Olariu-Al/pyrojack-animatronic/cat_eye_pumpkin_STL_v2C/parts_overview.png

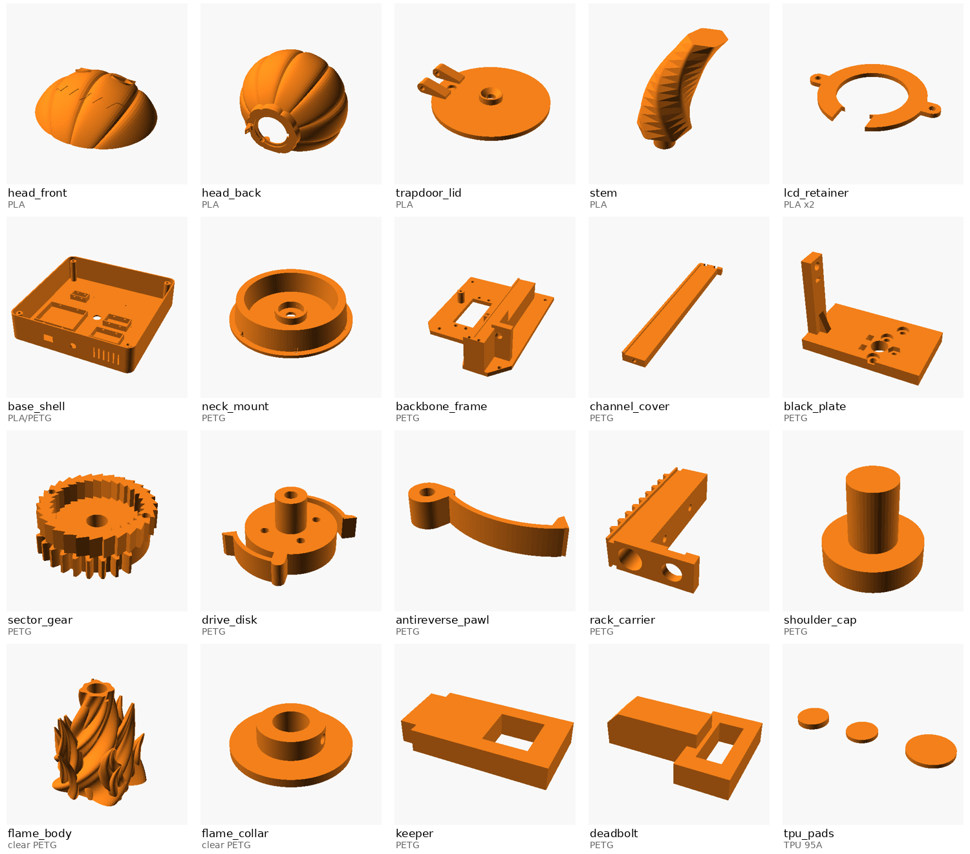
cat_eye_pumpkin_STL_v2C/parts_overview.png
