Olariu-Al/pyrojack-animatronic/cat_eye_pumpkin_STL_v2C/stl/tpu_pad_editat.STL

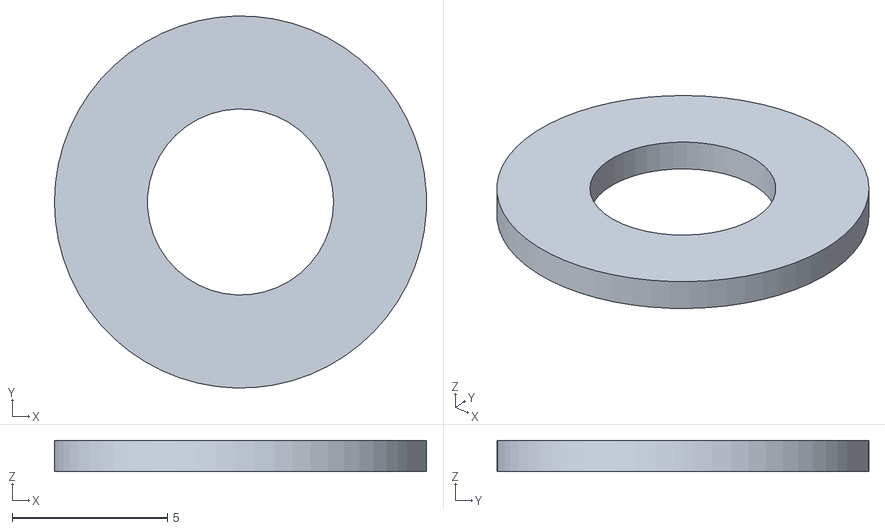
[picture p2: CAD file, 2026-10-29]
cat_eye_pumpkin_STL_v2C/stl/tpu_pad_editat.STL
12.0 x 12.0 x 1.00
