Olariu-Al/pyrojack-animatronic/pumpkin_v1C/stl/backbone_frame.3mf

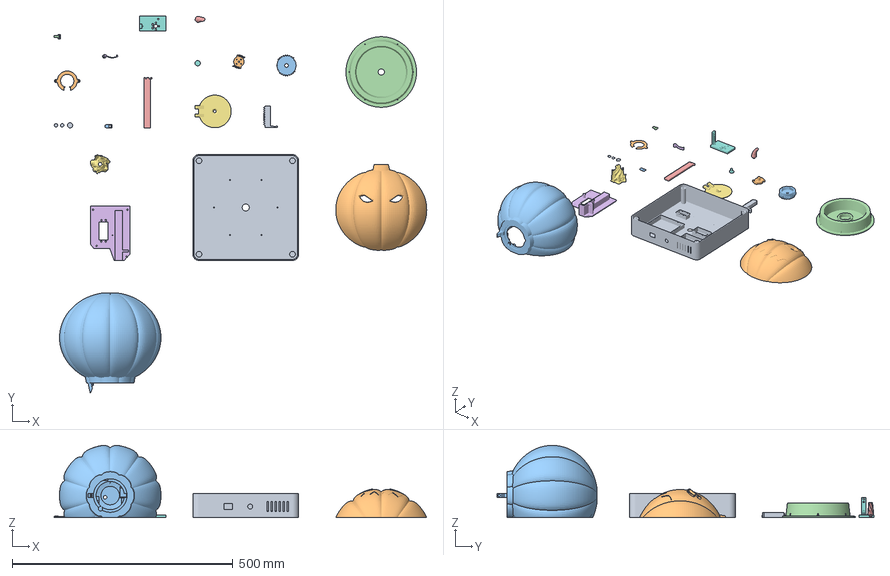
[picture p3: CAD file, 2026-10-23]
pumpkin_v1C/stl/backbone_frame.3mf
844.5 x 854.6 x 163.7 mm
tpu_pads.stl
lcd_retainer.stl
keeper.stl
deadbolt.stl
channel_cover.stl
antireverse_pawl.stl
trapdoor_lid.stl
shoulder_cap.stl
rack_carrier.stl
drive_disk.stl
sector_gear.stl
neck_mount.stl
stem.stl
backbone_frame.stl
flame_body.stl
black_plate.stl
base_shell.stl
head_front.stl
head_back.stl
