Olariu-Al/pyrojack-animatronic/cat_eye_pumpkin_STL_v2C/stl/everything.3mf

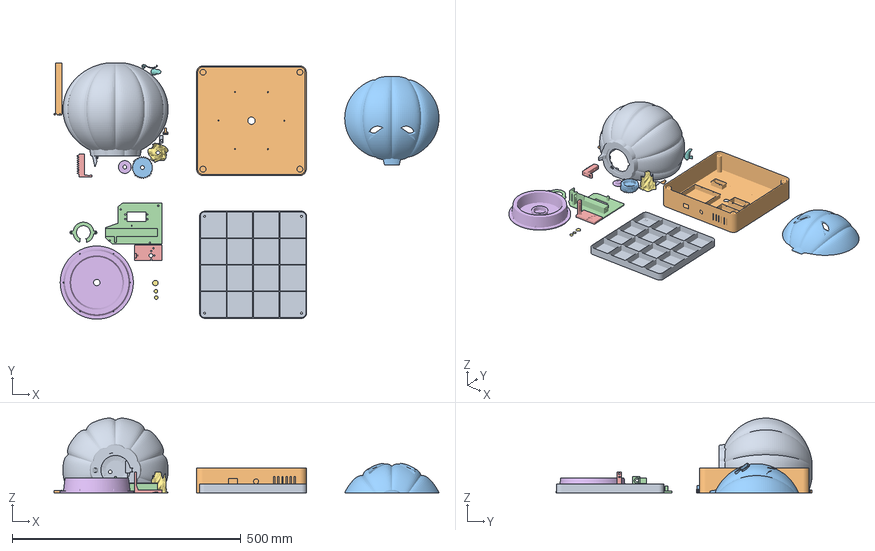
[picture p4: CAD file, 2026-10-25]
cat_eye_pumpkin_STL_v2C/stl/everything.3mf
842.3 x 560.8 x 163.7 mm
head_back.stl
base_shell.stl
head_front.stl
backbone_frame.stl
black_plate.stl
neck_mount.stl
flame_body.stl
stem.stl
base_lid.stl
channel_cover.stl
sector_gear.stl
lcd_retainer.stl
rack_carrier.stl
flame_collar.stl
tpu_pads.stl
antireverse_pawl.stl
keeper.stl
deadbolt.stl
