Olariu-Al/pyrojack-animatronic/cat_eye_pumpkin_STL_v2C/stl/base_lid.stl

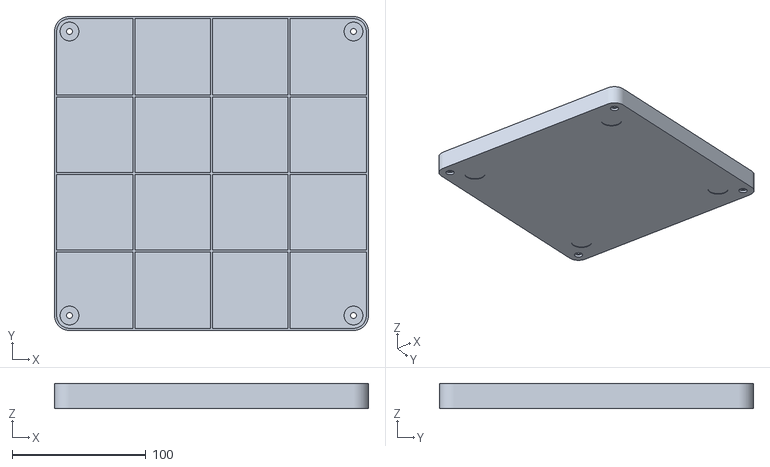
[picture p5: CAD file, 2026-10-25]
cat_eye_pumpkin_STL_v2C/stl/base_lid.stl
234.4 x 234.4 x 19.0
