Olariu-Al/pyrojack-animatronic/pumpkin_v1C/stl/flame_collar.stl

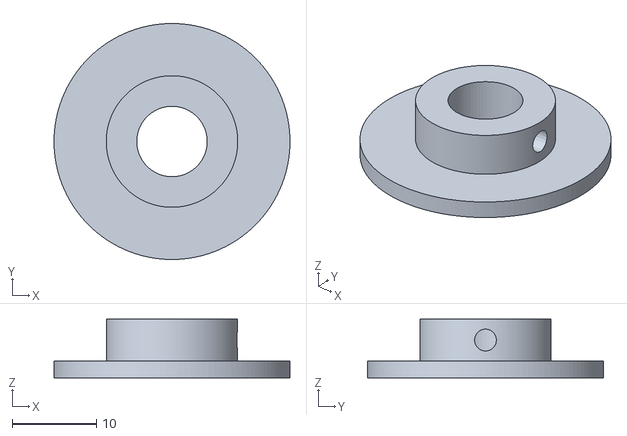
[picture p6: CAD file, 2026-10-23]
pumpkin_v1C/stl/flame_collar.stl
28.0 x 28.0 x 7.00
