Olariu-Al/pyrojack-animatronic/cat_eye_pumpkin_STL_v2C/stl/black_plate.stl

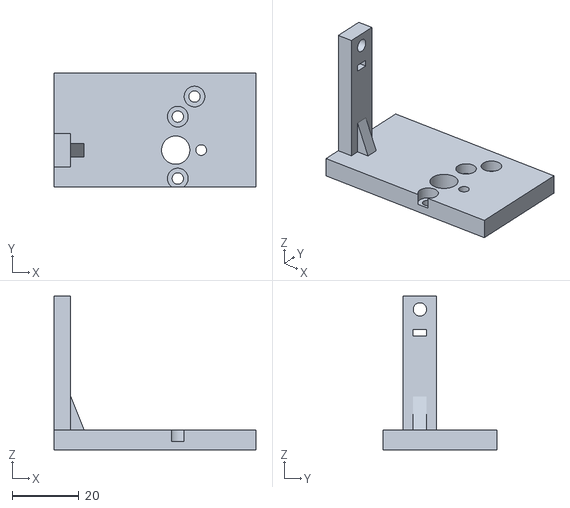
[picture p7: CAD file, 2026-10-23]
cat_eye_pumpkin_STL_v2C/stl/black_plate.stl
60.4 x 34.0 x 46.0
