Olariu-Al/pyrojack-animatronic/pumpkin_v1C/stl/tpu_pads.stl

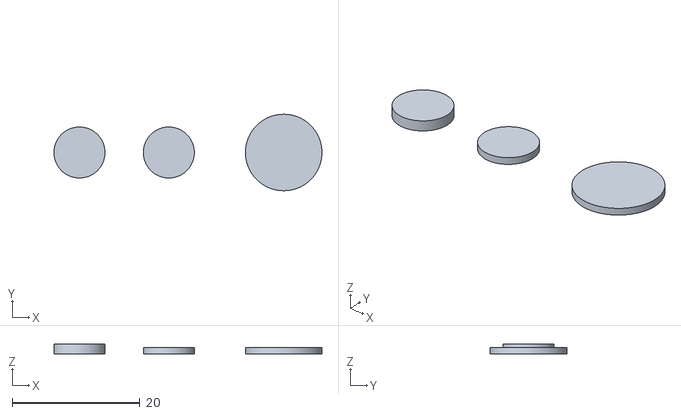
[picture p8: CAD file, 2026-10-23]
pumpkin_v1C/stl/tpu_pads.stl
42.0 x 12.0 x 1.50
