Olariu-Al/pyrojack-animatronic/cat_eye_pumpkin_STL_v2C/stl/head_back.stl

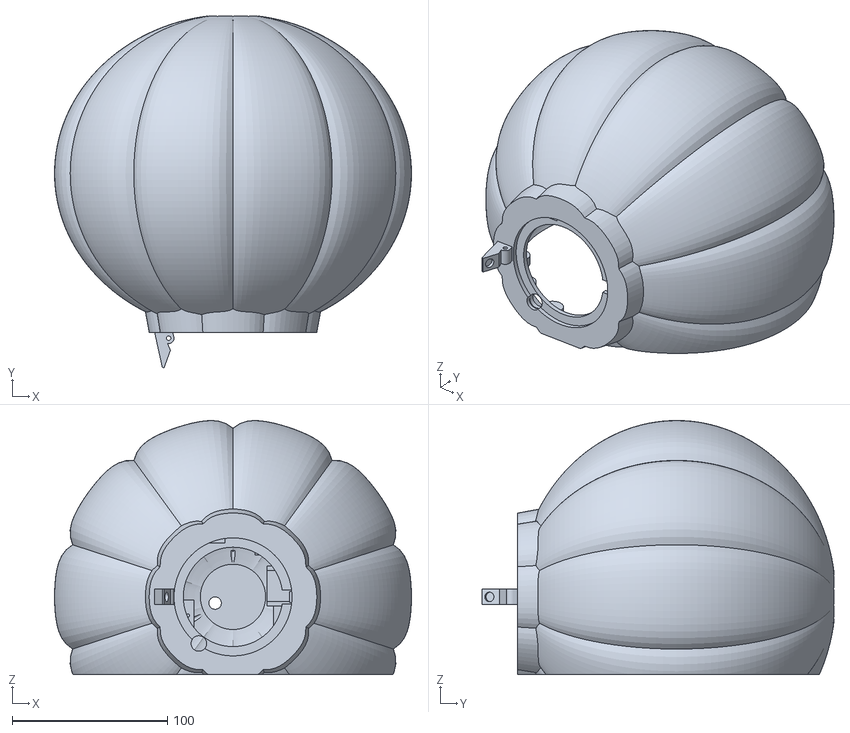
[picture p9: CAD file, 2026-10-23]
cat_eye_pumpkin_STL_v2C/stl/head_back.stl
230.0 x 226.6 x 163.7
