Olariu-Al/pyrojack-animatronic/pumpkin_v1C/stl/rack_carrier.stl

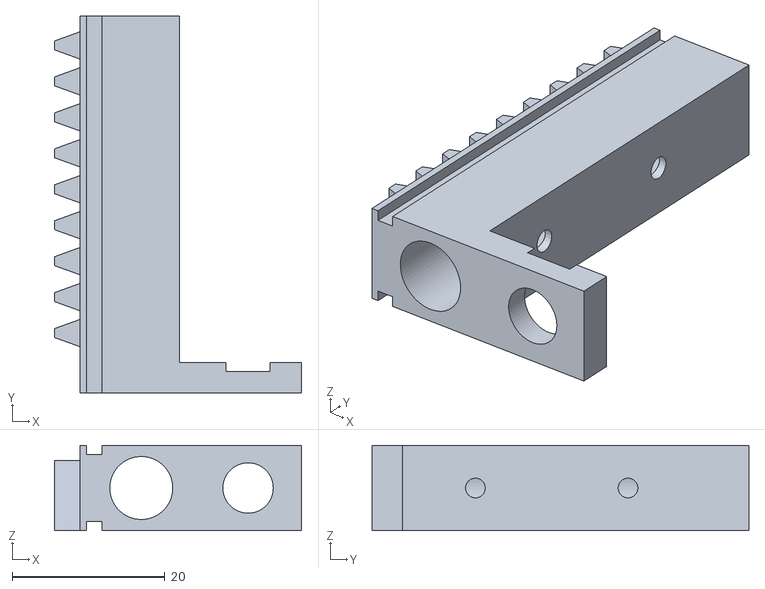
[picture p10: CAD file, 2026-10-23]
pumpkin_v1C/stl/rack_carrier.stl
32.4 x 49.4 x 11.2
