Olariu-Al/pyrojack-animatronic/cat_eye_pumpkin_STL_v2C/stl/backbone_frame.stl

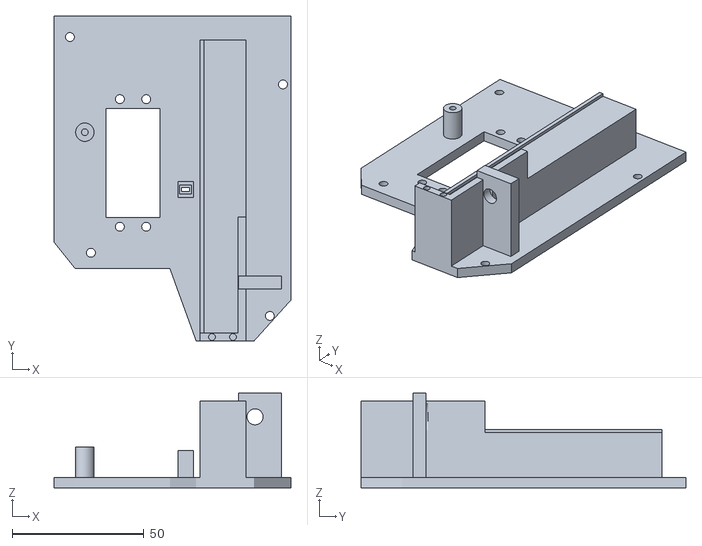
[picture p11: CAD file, 2026-10-23]
cat_eye_pumpkin_STL_v2C/stl/backbone_frame.stl
90.0 x 123.5 x 36.0
