Olariu-Al/pyrojack-animatronic/pumpkin_v1C/stl/channel_cover.stl

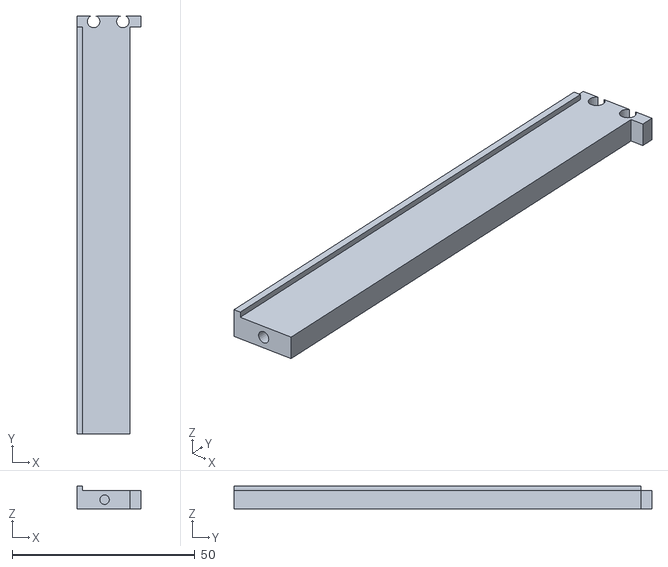
[picture p12: CAD file, 2026-10-23]
pumpkin_v1C/stl/channel_cover.stl
17.6 x 114.3 x 6.20
