Olariu-Al/pyrojack-animatronic/cat_eye_pumpkin_STL_v2C/stl/shoulder_cap.stl

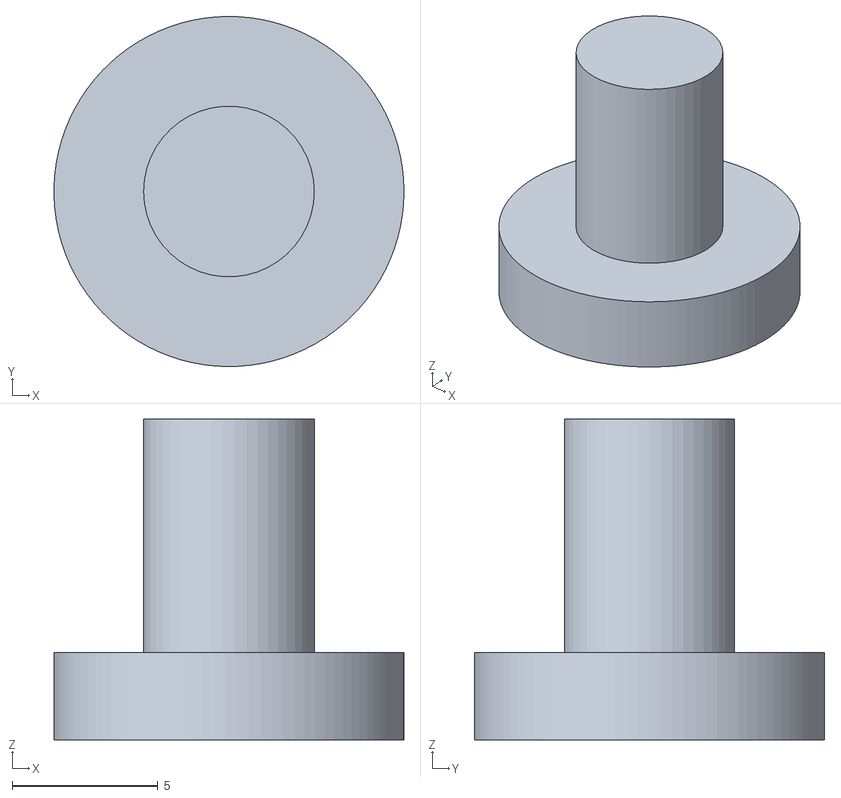
[picture p13: CAD file, 2026-10-23]
cat_eye_pumpkin_STL_v2C/stl/shoulder_cap.stl
12.0 x 12.0 x 11.0
