Olariu-Al/pyrojack-animatronic/pumpkin_v1C/stl/drive_disk.stl

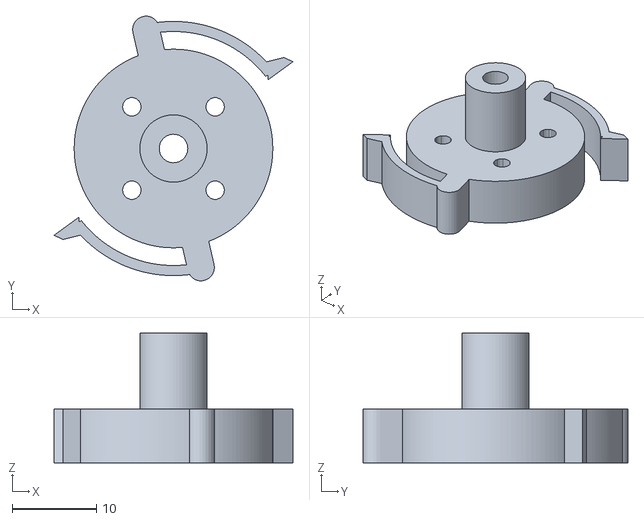
[picture p14: CAD file, 2026-10-23]
pumpkin_v1C/stl/drive_disk.stl
28.4 x 31.4 x 15.4
