Olariu-Al/pyrojack-animatronic/pumpkin_v1C/stl/black_plate.stl

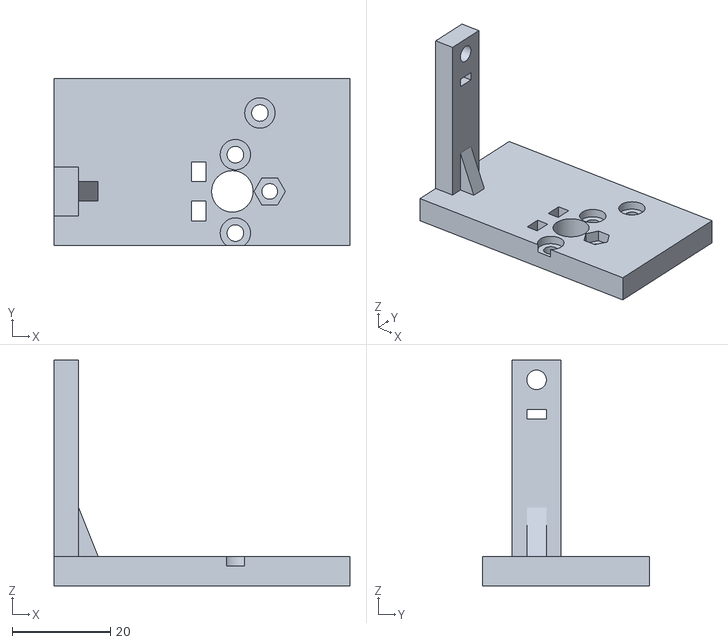
[picture p15: CAD file, 2026-10-23]
pumpkin_v1C/stl/black_plate.stl
60.4 x 34.0 x 46.0
