Olariu-Al/pyrojack-animatronic/cat_eye_pumpkin_STL_v2C/stl/lcd_retainer.stl

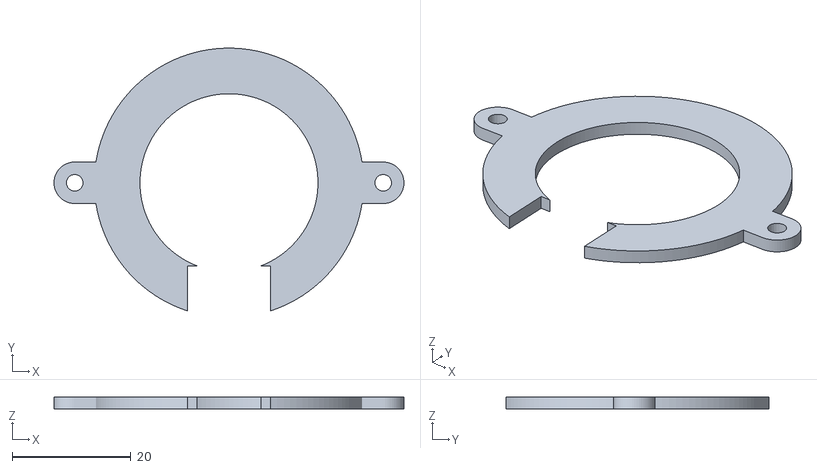
[picture p16: CAD file, 2026-10-23]
cat_eye_pumpkin_STL_v2C/stl/lcd_retainer.stl
59.0 x 44.3 x 2.00
