Olariu-Al/pyrojack-animatronic/cat_eye_pumpkin_STL_v2C/stl/base_shell.stl

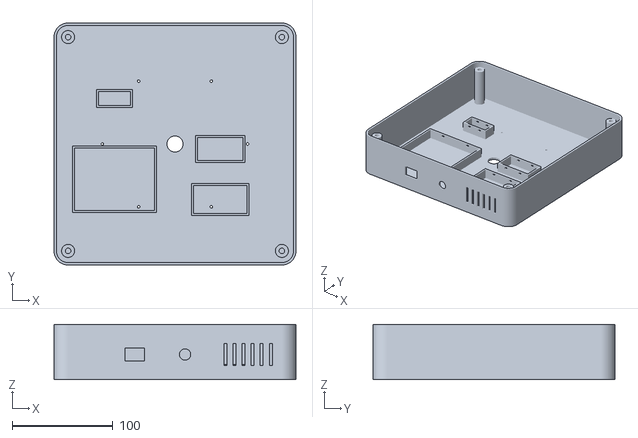
[picture p17: CAD file, 2026-10-23]
cat_eye_pumpkin_STL_v2C/stl/base_shell.stl
240.0 x 240.0 x 55.0
