Olariu-Al/pyrojack-animatronic/pumpkin_v1C/stl/head_front.stl

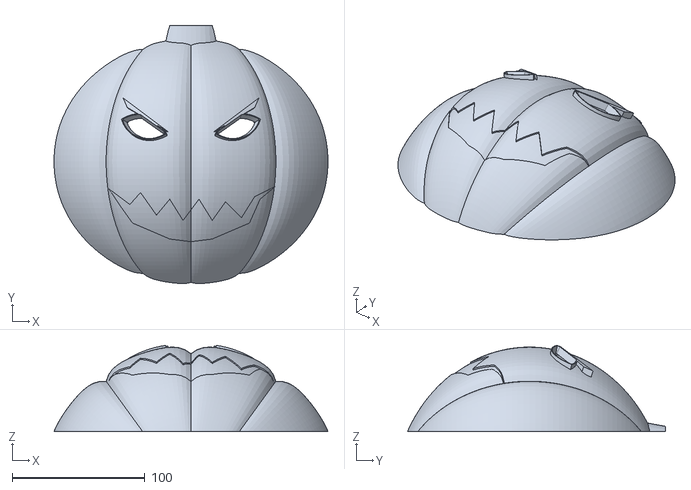
[picture p18: CAD file, 2026-10-23]
pumpkin_v1C/stl/head_front.stl
206.3 x 194.3 x 65.0
