Olariu-Al/pyrojack-animatronic/cat_eye_pumpkin_STL_v2C/stl/antireverse_pawl.stl

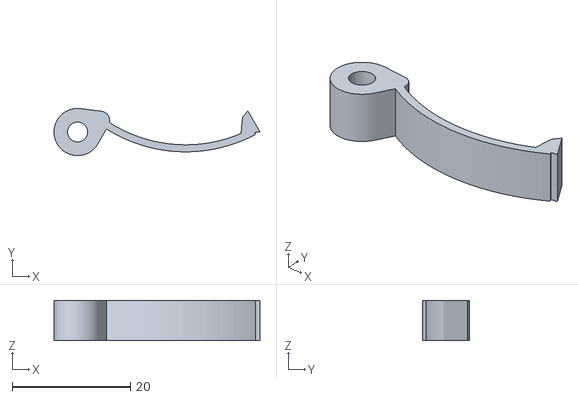
[picture p19: CAD file, 2026-10-23]
cat_eye_pumpkin_STL_v2C/stl/antireverse_pawl.stl
34.9 x 8.00 x 6.80
