Olariu-Al/pyrojack-animatronic/pumpkin_v1C/stl/neck_mount.stl

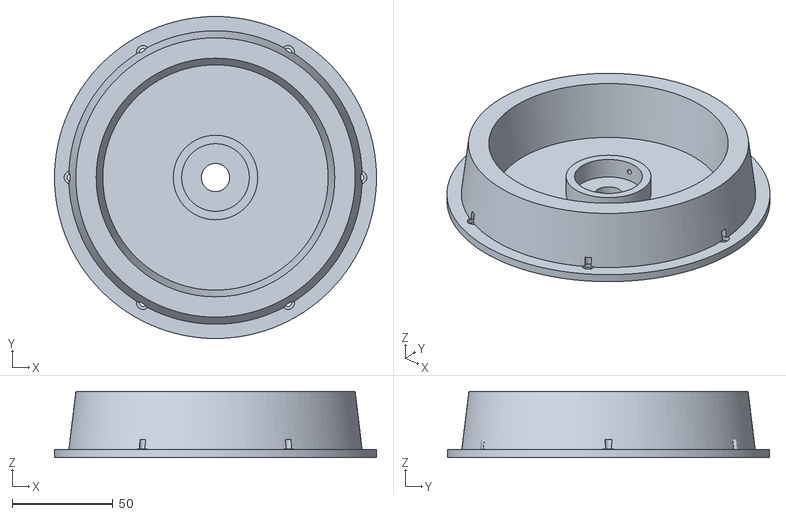
[picture p20: CAD file, 2026-10-23]
pumpkin_v1C/stl/neck_mount.stl
160.0 x 160.0 x 32.9
