Olariu-Al/pyrojack-animatronic/pumpkin_v1C/stl/stem.stl

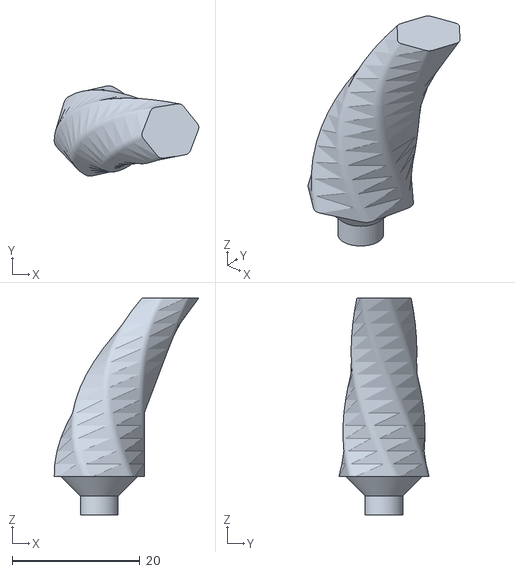
[picture p21: CAD file, 2026-10-23]
pumpkin_v1C/stl/stem.stl
22.7 x 14.2 x 34.0
