Olariu-Al/pyrojack-animatronic/cat_eye_pumpkin_STL_v2C/stl/sector_gear.stl

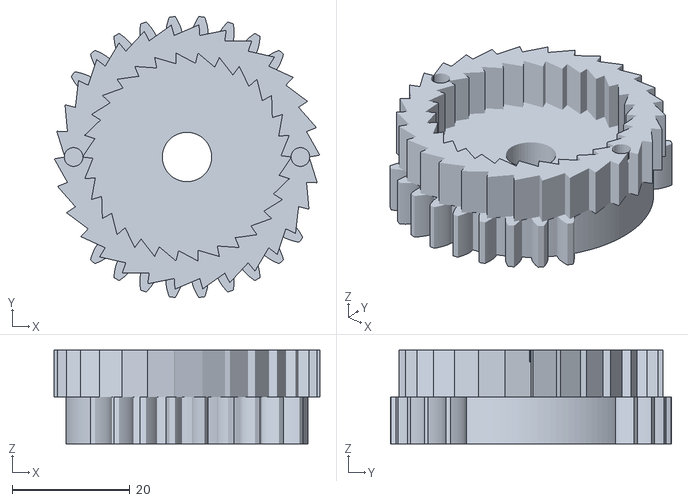
[picture p22: CAD file, 2026-10-23]
cat_eye_pumpkin_STL_v2C/stl/sector_gear.stl
45.2 x 47.8 x 16.0
