Olariu-Al/pyrojack-animatronic/pumpkin_v1C/stl/flame_body.stl

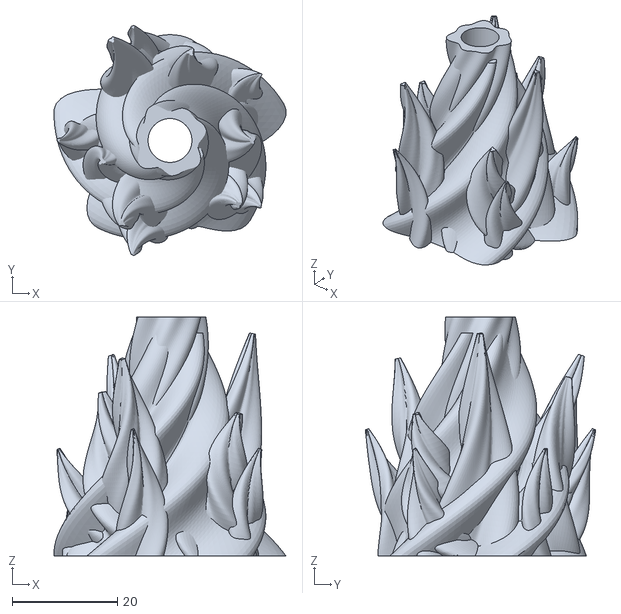
[picture p23: CAD file, 2026-10-23]
pumpkin_v1C/stl/flame_body.stl
44.2 x 43.9 x 45.5
