Olariu-Al/pyrojack-animatronic/pumpkin_v1C/stl/keeper.stl

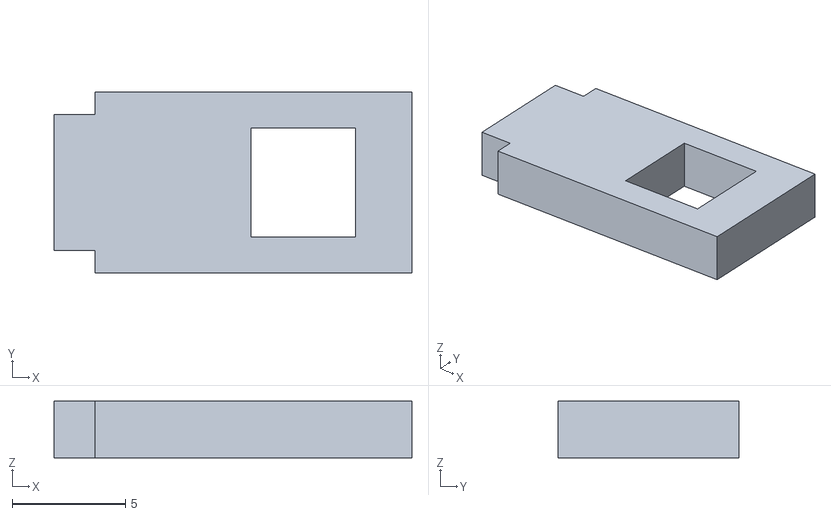
[picture p24: CAD file, 2026-10-23]
pumpkin_v1C/stl/keeper.stl
15.8 x 8.00 x 2.50
