Olariu-Al/pyrojack-animatronic/pumpkin_v1C/stl/trapdoor_lid.stl

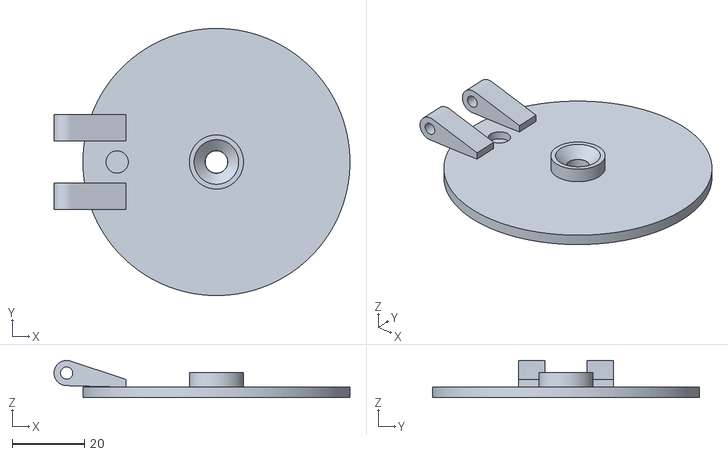
[picture p25: CAD file, 2026-10-23]
pumpkin_v1C/stl/trapdoor_lid.stl
82.0 x 74.0 x 10.3
