Olariu-Al/pyrojack-animatronic/(list of files, cad)

Other CAD files:
pumpkin_v1C/stl/head_back.stl
pumpkin_v1C/cat_eye_pumpkin.scad
cat_eye_pumpkin_STL_v2C/stl/deadbolt.stl
pumpkin_v1C/stl/backbone_frame.stl
pumpkin_v1C/stl/deadbolt.stl
