Olariu-Al/pyrojack-animatronic/(commit log)

2026-10-23 stl+scad
    all generic parts+ the scad under wait for supervision
    [antireverse_pawl.stl, backbone_frame.stl, base_shell.stl, black_plate.stl, cat_eye_pumpkin.scad, channel_cover.stl, deadbolt.stl, drive_disk.stl]
2026-10-23 v2c
    version 2 of the pumpkin with the software included and a building guide as well
    [antireverse_pawl.stl, backbone_frame.3mf, backbone_frame.stl, base_shell.stl, black_plate.stl, cat_eye_pumpkin.scad, channel_cover.stl, deadbolt.stl]
2026-10-25 lid+eveything
    created the lid cover + an stl that contains all parts
    [base_lid.stl, everything.3mf]
2026-10-29 benchmark test
    [tpu_pad_editat.STL]
